sgamp/CG_Scale_modifiedSG/README.md

# CG_Scale_modifiedSG
Modified version of the CG scale project from Olkal

*using a 0.96" OLED Display
*using a button field (5 buttons) to enter a reference weight and to navigate
*writing reference results to EEPROM
More information can be found in the *.pdf
