sgamp/CG_Scale_modifiedSG/Gerber - Eagle/pushbutton.brd

## EAGLE design Gerber - Eagle/pushbutton.brd (2018-12-12)

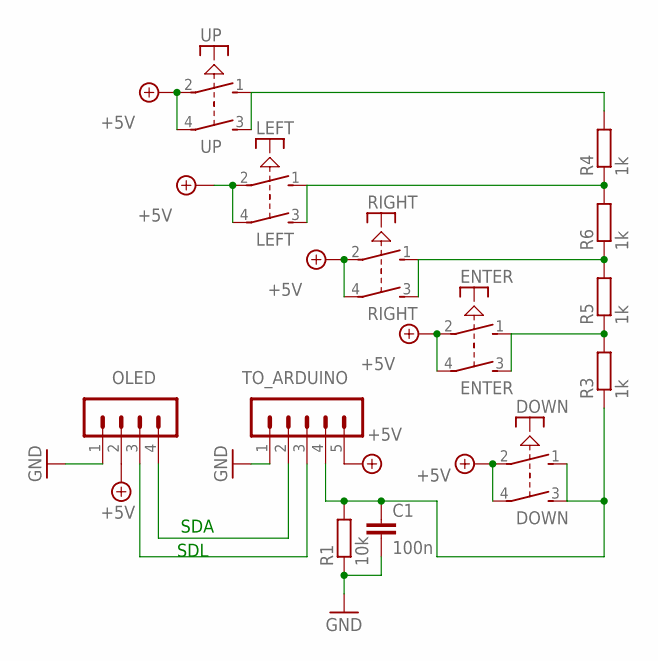
[picture p12: schematic pushbutton.sch]

Parts:
C1: 100n; C025-030X050
DOWN: PVA1R
ENTER: PVA1R
LEFT: PVA1R
OLED: MA04-1
R1: 10k; 0207/10
R3, R4, R5, R6: 1k; 0207/10
RIGHT: PVA1R
TO_ARDUINO: MA05-1
UP: PVA1R

Connections:
+5V: DOWN.2, DOWN.4, ENTER.2, ENTER.4, LEFT.2, LEFT.4, OLED.2, RIGHT.2, RIGHT.4, TO_ARDUINO.5, UP.2, UP.4
GND: C1.2, OLED.1, R1.1, TO_ARDUINO.1
unnamed: ENTER.1 (S), ENTER.3 (S), R3.2, R5.1
unnamed: R4.2, UP.1 (S), UP.3 (S)
unnamed: C1.1, DOWN.1 (S), DOWN.3 (S), R1.2, R3.1, TO_ARDUINO.4
unnamed: R5.2, R6.1, RIGHT.1 (S), RIGHT.3 (S)
unnamed: LEFT.1 (S), LEFT.3 (S), R4.1, R6.2
SCL: OLED.3, TO_ARDUINO.3
SDA: OLED.4, TO_ARDUINO.2

Notes on the sheet:
SDL
SDA

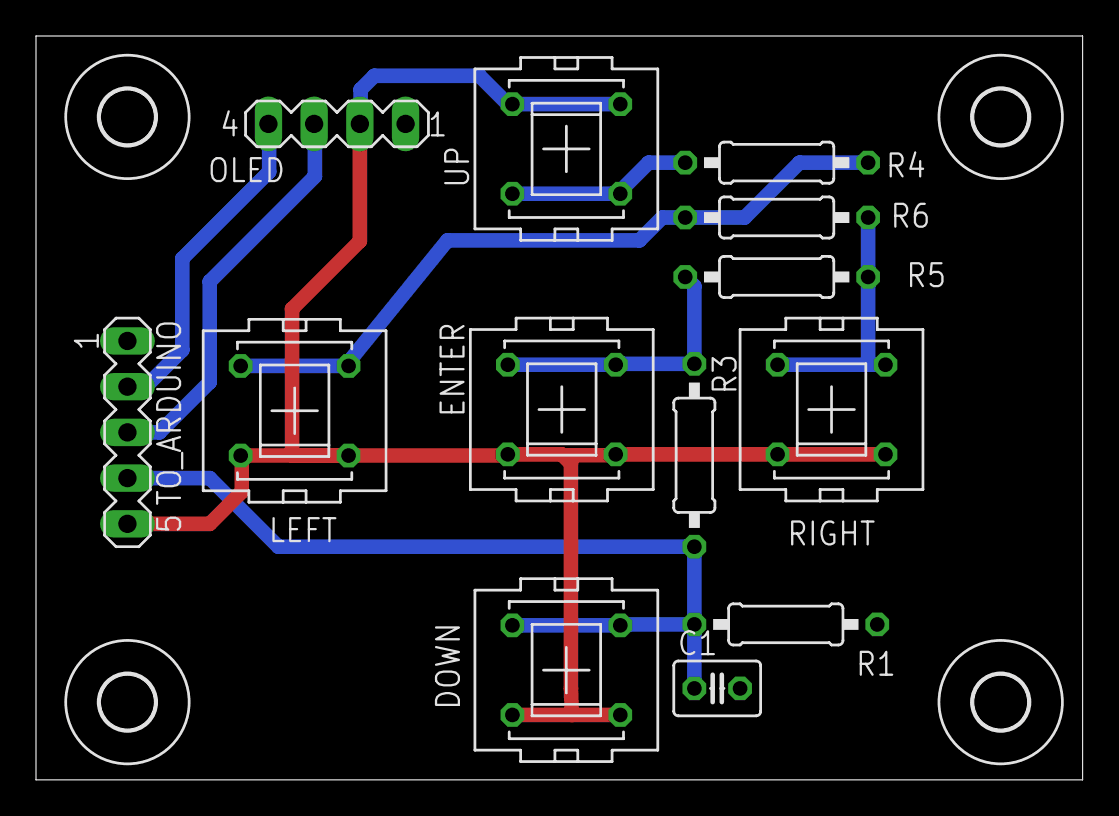
[picture p13: board pushbutton.brd from above]

Board: 2 copper layers, 58.1 x 41.3 mm, 17 parts (0 on the bottom side), 9 nets.

Other parts of the board:
U$1, U$2, U$3, U$4: 3,0
