sgamp/CG_Scale_modifiedSG/Gerber - Eagle/finalizeScale.brd

## EAGLE design Gerber - Eagle/finalizeScale.brd (2018-12-12)

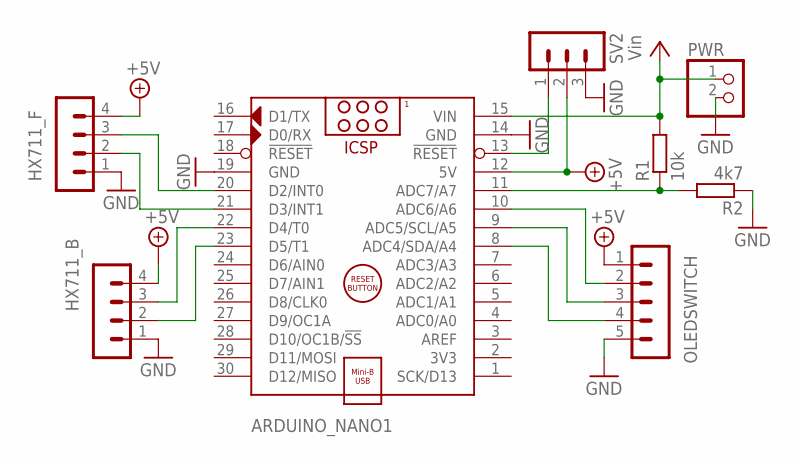
[picture p14: schematic finalizeScale.sch]

Parts:
ARDUINO_NANO1: ARDUINO_NANO
HX711_B, HX711_F: MA04-1
OLEDSWITCH: MA05-1
PWR: PINHD-1X2; 1X02
R1: 10k; 0207/10
R2: 4k7; 0207/10
SV2: MA03-1

Connections:
+5V: ARDUINO_NANO1.12 (5V), HX711_B.4, HX711_F.4, OLEDSWITCH.1, SV2.2
GND: ARDUINO_NANO1.14 (GND), ARDUINO_NANO1.19 (GND), HX711_B.1, HX711_F.1, OLEDSWITCH.5, PWR.2, R2.1, SV2.3
unnamed: ARDUINO_NANO1.8 (ADC4/SDA/A4), OLEDSWITCH.4
unnamed: ARDUINO_NANO1.9 (ADC5/SCL/A5), OLEDSWITCH.3
unnamed: ARDUINO_NANO1.11 (ADC7/A7), R1.1, R2.2
unnamed: ARDUINO_NANO1.21 (D3/INT1), HX711_F.2
unnamed: ARDUINO_NANO1.10 (ADC6/A6), OLEDSWITCH.2
unnamed: ARDUINO_NANO1.22 (D4/T0), HX711_B.3
unnamed: ARDUINO_NANO1.23 (D5/T1), HX711_B.2
unnamed: ARDUINO_NANO1.20 (D2/INT0), HX711_F.3
unnamed: ARDUINO_NANO1.13 (!RESET), SV2.1
VCC: ARDUINO_NANO1.15 (VIN), PWR.1, R1.2

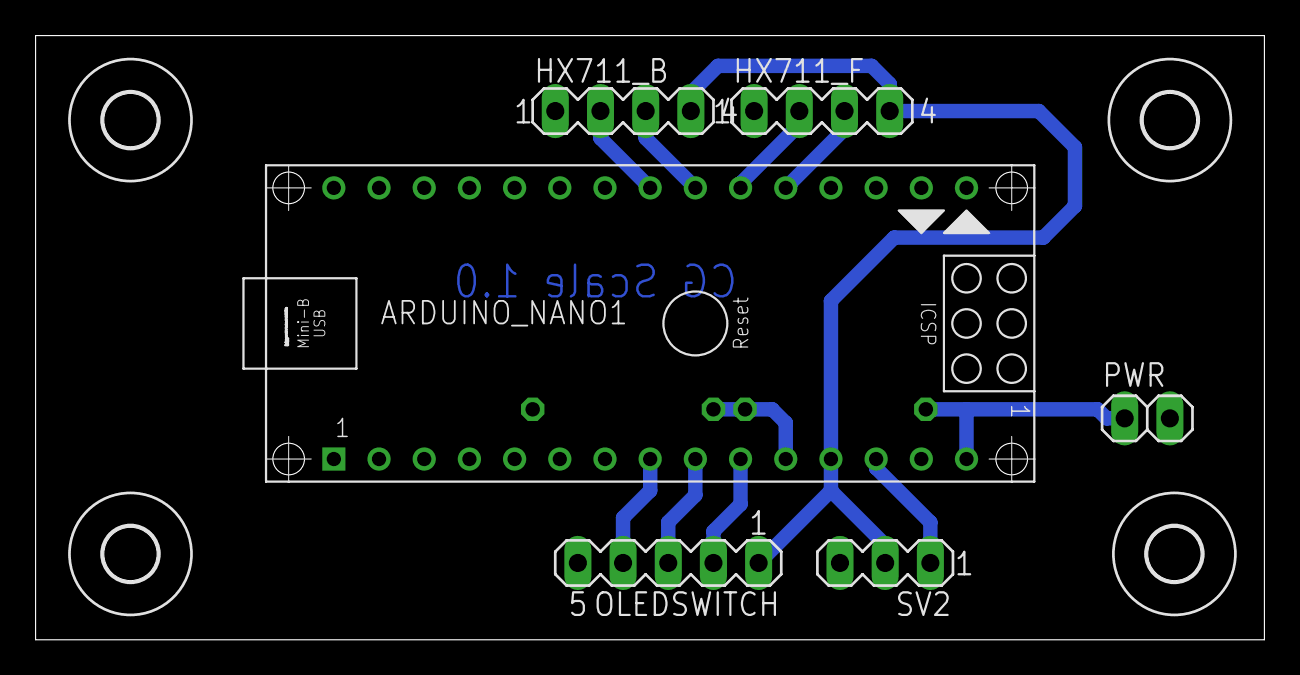
[picture p15: board finalizeScale.brd from above]

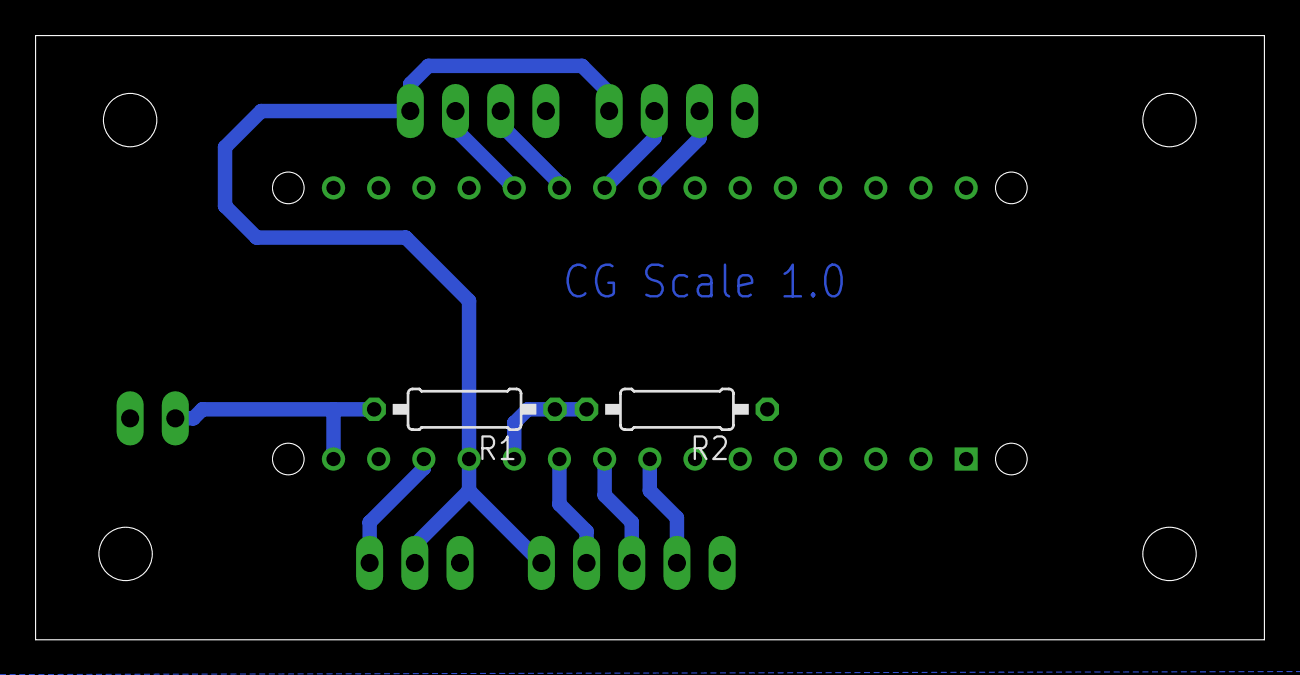
[picture p16: board finalizeScale.brd from below]

Board: 2 copper layers, 69.1 x 34.0 mm, 12 parts (2 on the bottom side), 12 nets.

Other parts of the board:
U$1, U$2, U$3, U$4: 3,0
