sgamp/CG_Scale_modifiedSG/(threads)

Thread 1 (2019-01-27):

Pins in Sketch don't match code

rbzhlgg, 2019-01-27:
Hi Stephan,

to allign the pin labeling in schematic (2) in the PDF with the code, the pins of front / back scale must be like this:

//HX711 constructor (dout pin, sck pin)
HX711_ADC ScaleBack(2, 3);
HX711_ADC ScaleFront(4, 5);

In your code front and back pins are switched.

Br
Georg

sgamp, 2019-01-31:
Hi Georg,
many thanks for your hint. I corrected the drawing in the *.pdf
